thepowersgang/fyp-boat/tools/dumb_proxy/README.md

Dumb proxy that just echoes from one connection to another (multi-threaded)
