thepowersgang/fyp-boat/tools/mavlink_proxy_server/README

Hackjob program to receive, parse, and re-send mavlink messages (supporting a ground station that intermittently connects to the server)
