thepowersgang/fyp-boat/DesignNotes/ZZ-APMplannerConfig.md

Serial Connection
-----------------

For wireless dongle:
- /dev/ttyUSB0 at 57600 baud

For USB:
- /dev/ttyACM0 at 115200 baud

For 3G:
- TODO!

Joystick Config
---------------

This places all control on the lefthand sitck of a Logitech dual action

Throttle: Axis 1 (Reversed)
Roll: Axis 2
