thepowersgang/fyp-boat/DesignNotes/20170327-AlternateMotors.txt

Requirements
============

- 12V input
- Max 4W power consuption

Notes
=====

- `Kv` - RPM per Volt at no load

Extras
=====

Shaft
-----
- OPTION - [https://hobbyking.com/en_us/4mm-drive-shaft-and-prop-set.html](HobbyKing)

Propeller
---------
- 57mm diameter, 3 blade prop (2x) - [https://hobbyking.com/en_us/3-blade-boat-propellers-40x57mm-2pcs-bag.html](Link)
 - Plastic
 - Price: $2.23 per pair
- NOTE: 4.8mm (3/16") shaft hole
- Pitch is ~58mm (inferred), requires ~1000rpm motor to meet 1m/s

Options
=======

CDM - DC Brushless Motor for Fanner, 12V 6000rpm No Load, 4W Output Power
------
- "CDM" CDM-BL3626I-T1201
- [http://www.globalsources.com/si/AS/Dongguan-Country/6008849101954/pdtl/DC-Brushless-Motor/1123731124.htm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](Store link)
- Extras:
 - PWM input
 - Speed feedback

Brushless DC Motor with Encoder 12V 159RPM
----
- "DFRobot Australia" DF-FIT0441
- NOTE: Unknown power, probably 4W
- [https://littlebirdelectronics.com.au/products/brushless-dc-motor-with-encoder-12v-159rpm](Store Link) 
- Extras:
 - PWM speed control
 - Direction control
 - Feedback pulse output
- NOTE: Will likely require a shaft seal to keep the motor inside and dry.
 - Shaft extension: 
 - Shaft seal: [http://www.sealingaustralia.com.au/v-rings/](3.5mm seal)
 - Plug: ? (must be about 1cm diameter to fit the above seal)

- PROBLEM: 159 RPM is far too slow for our needs. Need about 500RPM to meet 1m/s with most small props

OpenROV motors
--------------
- [https://store.openrov.com/collections/2-8-replacement-parts/products/motor-set](Store Link)
 - [https://hobbyking.com/en_us/turnigy-aerodrive-dst-700-brushless-outrunner-motor-700kv.html](Direct motor link)
 - Possible - [https://forum.openrov.com/t/dst-700-motors-for-salt-water-mark-motors-part-3/1942/6](Waterproofing patch)
- Brushless DC motors with insulation changes
- Require silicon lubricant to prevent corrosion in salt water.
- Max power: 140W
 - NOTE: This is higher than the BlueRobotics motors (at 130W)
- No-load power: 7.2W

Submersible Pump (Bilge Pump)
--------------
- Suggested by [http://www.instructables.com/id/How-to-build-a-thruster-for-a-homemade-submersible/?ALLSTEPS](Instructables)
- Uses a 4160 l/hr pump (1.2l/sec)
 - [http://www.bcf.com.au/Product/Rule-Bilge-Pumps/124209](Store Link)
 - 3.3A max draw - ~40W
- (+) Already watertight (well, can handle being underwater)
- (-) Possibly unable to go backwards? (Not sure if the motor is capable of running in reverse)
- [http://store.waterpumpsupply.com/runo12vodcbi.html](Extra stats)

Internal Motor
-------------
- Motor [https://hobbyking.com/en_us/turnigy-xk3674-1400kv-brushless-inrunner.html](HobbyKing)
- Gearbox [https://hobbyking.com/en_us/gear-box-1-5mm-10t-64t.html](HobbyKing)

Water Feature Pump
-----------------
- [https://www.bunnings.com.au/aquapro-low-voltage-water-feature-pump_p2810056](Bunnings)
- "Thrust" - 750l/h at 1.5m head

Electic Outboard
-------------------
- [http://www.bcf.com.au/Product/Watersnake-Electric-Motor-Transom-Mount-18lb/165724](BCF)
 - AU$169
- 18lbf (8.1kgf / ~85N) peak thrust
- 12V with 15A max draw (unit has two settings, 15A and 7A)
 - [https://www.jarviswalker.com.au/catalogue/boating/watersnake-motors/transom-mount-electric-motors/watersnake-kayak-motor-bracket-combo.html](Manufacturer?)
 - 180W peak, 84W for low power mode

Decision
========

Easiest: Bilge Pump
------------------
The easiest option here is using a small bilge pump. These are designed to be submerged un seawater, and have been shown to work as thrusters. The only downside of taking one of these is that it is unknown if they can be run backwards (very quick investigations say no).
The other risk here is that these motors may not be very easy to regulate (with the only regulation option being avaliable power, no speed feedback).

The lack of reverse may not be an issue, assuming we do not need to do precise station keeping (or have to do a standing/sharp turn)

Second: OpenROV motors
---------------------
The OpenROV motors are not sealed, so they will either need to be treated to withstand constant immersion in a saline enviroment, or we hope that constant immersion won't cause issues. These have the large upside of being fully regulatable DC motors (so they can be reversed and have a controllable speed). The problem here is that our constant driving power is quite a bit below their max power rating (and is around their zero-load power drain).

Third: Just use a BlueRobotics thruster
-------------------
Since the OpenROV motors are so overpowered (compared to our power capacity), we could just got for the BlueRobotics thrusters (already used on one of the AUVs), and run them at the peak efficiency point.

Fourth: Internal motor connected via a shaft seal
--------------------------
Complex, but allows using a fully-featured and well-sized motor without caring about getting it wet. Problem may be finding a suitably sized seal for the motor shaft. (Shrink-wrap spacers could be used to pad out the shaft so it fits the seal, or a larger shaft could be attached).

Calculations
============

Thrust
------

Most recent drag calculation is _41N_ (at an unknown velocity, likely 1.3m/s)

Effective thrust is calculated by multiplying the shaft RPM by the advance of the propellor (and reducing to account for compression, rotation, and edge losses)
- Prop advance: 18mm run, ~110 degrees, ~25mm blade length (assume flat, it isn't)
 - Pitch is the distance the prop would move if the fluid were non-compressable
 - P ~= C / W * L => P = 360 / 110 * 18mm = ~58mm pitch
 - P * Area of blades ~= volume of moved water
 - `58mm * (2 * pi * 57^2 - 2 * pi * 6^2)` (6mm hub assumed)
  - `1.17e6` mm^3 per revolution (1.171 l/rev)
 - Water is moved at a speed of `RPM / 60 * Pitch`
 - Force comes from the difference between intake and exhaust velocities
 - A ballpark time (for acceleration and hence force) can be obtained by assuming a mean velocity of `(V_{in} + V_{out}) / 2`

- `V_{out} = RPM / 60 * 58mm`
- `deltaV = V_{out} - V_{in}`
- `time = 58mm / (V_{in}/2 + deltaV/2)`
- `accel = deltaV / time`
 - `accel = (V_{out} - V_{in}) / ( 58mm / (V_{in}/2 + V_{out}/2) )`
 - `accel = (V_{out} - V_{in}) * (V_{in}/2 + V_{out}/ 2) / 58mm`
 - `accel = (V_{out}^2 - V_{in}^2) / (2 * 58mm)`
- `force = 1.171kg * accel`

### DST-700 (OpenRov)
- Test data from [https://hobbyking.com/en_us/turnigy-aerodrive-dst-700-brushless-outrunner-motor-700kv.html](HobbyKing)
 - 0.82kgf (8N) thrust at 130W
 - Assume linear (bad assumption), max thrust at ~5W draw would be 0.31N

### BlueRobotics
- T200 has peak efficiency at 1570us, 0.51lbf (2.26N) thrust at 5.51W draw.
 - Required draw for overcoming above drag is 79W ea (1770us)

### FIT0441
- 159RPM, using above calc that's about 186l/min moved at max speed (assuming no slip and no loss)
 - Static thrust (`V_{in}=0`) with 58mm pitch prop is approximately 0.25N

### Bilge Pump ("Rule" 25D)
- Numbers from [http://store.waterpumpsupply.com/runo12vodcbi.html](Extra stats)
 - 6.7' head height can deliver 180GPH at 12V (680LPH)
 - 2.04m at 0.19l/s
 - 2.04m of water assuming the pipe diameter constant at 1.9cm gives a volume of 4.6 liters (~4.6 kg)
 - 4.6kgf (45N) at max power 1.9A/12V
 - Assuming linear relation of power to thrust, at ~5W we'd get 9.8N thrust per motor

### Water pump
- Obtain exhaust speed from output diameter and flow rate.
 - `v = rate / output_area`
- E.g. 750LPH pump pushing a 20mm tube
 - `v = ( 750 / 1000 / 3600 ) / (pi * 0.02^2)` (working in meters and seconds)
 - `v = 0.165... m/s`

- TODO: Head height vs avaliable force.

<!-- vim: ft=markdown
-->
