thepowersgang/fyp-boat/DesignNotes/Block Diagram 2.odp

Satellite Modem

Motor Controller

APM2.8 Board

Battery

12V → +Vin

0V → GND

DC-DC

Solar Panel

Motor + Prop

Motor + Prop

Data Logger

GPS
