thepowersgang/fyp-boat/DesignNotes/Block Diagram.pptx

Data logger

TTL UART
→UART0 (3DA-RADIO)

GPS

TTL UART
→ UART1 (GPS)

3.3V→3.3V
GND → GND

Satellite

TTL UART
→UART2 (Pads)
GND → GND

12V → 12V
0V → 0V

IO board
- APM2.6

Output 1 → PWM1
Output 2 → PWM2
Output 3 → DIR1
Output 4 → DIR2
GND → GND

+Vout → 5V
COM → GND

Regulator

12V → +Vin
0V → COM

Port

Propeller

Motor

M1A,M1B

Motor driver

Propeller

Starboard

Motor

M2A,M2B

12V → B+
0V→ B-

Battery

12V → 12V
0V → 0V

Solar panel
