thepowersgang/fyp-boat/Documents/0x-FinalPartsList.tex

\documentclass{article}
\begin{document}

\section{Major Components}
\begin{itemize}
\item{Autopilot} - ArduCopter v2.8 Board
\item{Serial proxy} - XTWduino nano V3.0 (ATMEGA328P)
\item{Batteries} (4) Henda HT12V3.3 Sealed Lead-Acid Batteries
\item{Motors} (2) BlueRobotics T100 thrusters
\end{itemize}

\section{Connections}
\begin{itemize}
\item{Power Cable} (?m) DC power cable
\item{Data Cable} (?m) signal cables
\item{APM Power Connection (housing)} (1x) Hirose DF13 6S 1.25C
\item{APM Telemtry Connection (housing)} (1x) Hirose DF13 5S 1.25C
\item{Hirose Pin Crimps} (11) Hirose DF13 Crimp Terminal Female
\item{Battery Connectors} (2x4) 4.8mm spade crimps female
\end{itemize}

\subsection{Battery Connectors}
\begin{itemize}
\item \url{http://www.altronics.com.au/p/h1991a-red-4.8mm-female-spade-crimp-pk-10/} Altronics - 10 pack (red)
\item \url{http://www.altronics.com.au/p/h1994a-blue-4.8mm-female-spade-crimp-pk-10/} Altronics - 10 pack (blue)
\end{itemize}

\end{document}
