thepowersgang/fyp-boat/Documents/BillOfMaterials.ods

Sheet: Sheet1
Bill of Materials (BOM)
 |  | INPUT |  |  |  | ALERT
Component | Unit Qty. | Unit Cost ($) | Shipping ($) | Net Cost (?) | Currency | Net Cost ($) | Store | Location | Manufacturer Product ID | Arrived (Y/N) | Stock Qty. | unit | Qty. Used | unit | Link
Solar Panel | 1 | $261.84 | $0.00 | $261.84 | AUD | $261.84 | Ebay | Online |  | N | 0 | pce | 0 | pce | http://www.ebay.com.au/itm/132017117168
Solar Charger | 1 | $31.21 | $0.00 | $31.21 | AUD | $31.21 | Ebay | Online |  | N | 0 | pce | 0 | pce | http://www.ebay.com.au/itm/172343909750
Thrusters + ECU | 2 | $144.00 | $35.00 | $323.00 | USD | $439.28 | BlueRobotics | Online |  | N | 0 | pce | 0 | pce | http://bluerobotics.com/store/thrusters/t100-thruster/
Bracket | 2 | $5.00 | $0.00 | $10.00 | USD | $13.60 | BlueRobotics | Online |  | N | 0 | pce | 0 | pce | http://bluerobotics.com/store/thrusters/t100-p-bracket-r1/
RS232→TTL Board | 1 | $6.25 | $0.00 | $6.25 | AUD | $6.25 | Ebay | Online |  | N | 0 | pce | 0 | pce | http://www.ebay.com.au/itm/262728237318
5V Suply | 1 | $4.95 | $0.00 | $4.95 | AUD | $4.95 | GPIO Australia | Online |  | N | 0 | pce | 0 | pce | https://www.buyraspberrypi.com.au/shop/12-volt-to-5-volt-3000ma-step-down-transformer/
2.25mm 4pin DF13 | 1 | $1.40 | $0.00 | $1.40 | AUD | $1.40 | RS Electronics | Online |  | N | 0 | bag | 0.1 | bag | http://au.rs-online.com/web/p/pcb-connector-housings/0143009/
2.25mm 6pin DF14 | 1 | $1.22 | $0.00 | $1.22 | AUD | $1.22 | RS Electronics | Online |  | N | 0 | bag | 0.1 | bag | http://au.rs-online.com/web/p/products/0143021/
2.25mm crimps | 1 | $7.95 | $0.00 | $7.95 | AUD | $7.95 | RS Electronics | Online |  | N | 1 | bag | 0.1 | bag | http://au.rs-online.com/web/p/pcb-connector-contacts/5038325/
2.1mm DC Jack | 1 | $2.09 | $0.00 | $2.09 | AUD | $2.09 | RS Electronics | Online |  | N | 0 | pce | 1 | pce | http://au.rs-online.com/web/p/dc-power-plugs/5051558/
Various Wire (26AWG) | 3.7 | $0.30 | $0.00 | $1.11 | AUD | $1.11 | Altronics | Perth |  | N | 0 | m | 3.7 | m | http://www.altronics.com.au/cable/hookup-non-shielded/?prdv=26AWG
Power Wire | 3.3 | $0.75 | $0.00 | $2.48 | AUD | $2.48 | Altronics | Perth |  | N | 0 | m | 3.3 | m | http://www.altronics.com.au/p/w2110-20-0.18-white-red-figure-8-cable/
 |  |  | Subtotal: |  |  | $745.93 |  |  |  |  | Actual Cost: |  | $6.73

Sheet: Sheet2
AUD | 1
USD | 1.36
