thepowersgang/fyp-boat/DesignNotes/parts-list.xlsx

item | link | original price | AUD | shipping cost | quantity | subtotal
Electronics Enclosure | https://www.jaycar.com.au/snap-fit-abs-enclosure-80-6-x-80-x-43-5mm/p/HB6008 | * | 5.95 | 7 | 1 | AUD 5.95
Devantech CMPS-11 tilt-compensated compass | https://www.robotgear.com.au/Product.aspx/Details/892-Devantech-CMPS11-Tilt-Compensated-Compass-Module | * | 43.95 | 9.9 | 1 | AUD 43.95
Seeeduino Mega | https://www.seeedstudio.com/Seeeduino-Mega-p-717.html | * | 56.8 |  | 1 | AUD 56.80
Pololu Servo MUX Board | https://core-electronics.com.au/pololu-4-channel-rc-servo-multiplexer-partial-kit.html | * | 10.35 | 3 | 1 | AUD 10.35
Breadboard | http://au.element14.com/multicomp/mcbb400/breadboard-solderless-abs/dp/2395961?mckv=s|pcrid|59148083448&gross_price=true&CATCI=pla-173777570208&CAAGID=12550800888&CMP=KNC-GOO-SHOPPING-2395961&CAGPSPN=pla&gclid=CNqCmq6iwdICFQsFKgodZkID6w&DM_PersistentCookieCreated=true&CAWELAID=120185580000282207 | * | 4.884 |  | 1 | AUD 4.88
Servo | https://www.jaycar.com.au/mini-servo-4-8v-6v/p/YM2760 | * | 19.95 |  | 1 | AUD 19.95
Rudder control arm (connects to servo) |  | * | 10 |  | 1 | AUD 10.00
Rudder(made of balsa, balsa sheet 0.8mm/100mm/915mm) | https://www.balsacentral.com/collections/balsa-sheets/products/plywood-2mm-to-10mm | * | 3.75 | 16.5 | 1 | AUD 3.75
Solar Cells | https://www.vicoffroad.com.au/12v-200w-solar-panel-kit-home-generator-caravan-camping-power-mono-charging-641.html.html | * | 178.95 | 0 | 1 | AUD 178.95
Boat deck (0.6mm / 300x915mm) | https://www.balsacentral.com/collections/balsa-sheets/products/plywood-2mm-to-10mm | * | 13.1 | 0 | 5 | AUD 65.50
Hull |  | * | 50 |  | 1 | AUD 50.00
Carbon fiber shafts with embedded electronics wiring | http://exelwebstore.com.au/exel-crosslitetm-hiilikuituputki-22-mm-740.html | * | 76.96 |  | 1 | AUD 76.96
Voltage Regulator | https://www.jaycar.com.au/products/active-components/regulators/fixed-voltage/c/212A | * | 1.85 | 0 | 1 | AUD 1.85
Battery controller and D/C regulator | http://au.element14.com/murata-power-solutions/okr-t-10-w12-c/dc-dc-converter-non-iso-pol-1/dp/1792312?mckv=s|pcrid|59148083448&gross_price=true&CATCI=aud-112905144048:pla-173777534688&CAAGID=12550800888&CMP=KNC-GOO-SHOPPING-1792312&CAGPSPN=pla&gclid=CJyi0M7bw9ICFVNwvAodVqEAsA&CAWELAID=120185580000194262 | * | 21.406 | 0 | 1 | AUD 21.41
Batteries/12V 40AH | http://www.batteriesdirect.com.au/shop/product/4424/ns40zlsmf.html?gclid=CIC02unn49ICFVgnvQodf2gEQw | * | 95 | 36.29 |  | AUD 95.00
Balancing Board | https://www.balsacentral.com/products/balsa-sheet?variant=26782433667 | * | 4.65 | 0 | 1 | AUD 4.65
4:1 belt drive reduction using GT2 timing belt | https://australianrobotics.com.au/collections/linear-motion/products/gt2-timing-belt-and-pulleys-pack | * | 18.95 |  | 1 | AUD 18.95
brushless motor/ | http://www.ebay.com.au/itm/131723659050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 | 0 | 0 | 0 | 0 | 0
Keel enclosure | this is made by using a mold. I asked what is made of. | * | 0 |  | 1 | AUD 0.00
Two way satellite modem from Rock Seven | https://www.rock7.com/shop-product-detail?productId=4 | £209+bundle price £20 | 306.099 | £29.95 | 1 | AUD 306.10
audino nano | https://core-electronics.com.au/arduino-nano-v3-2.html | * | 36 | 3 | 1 | AUD 36.00
Adafruit GPS | https://core-electronics.com.au/adafruit-ultimate-gps-breakout-66-channel-w-10-hz-updates-version-3.html | * | 67 | 3 | 1 | 67
battery charger
motor driver | http://www.robotshop.com/en/10a-5-30v-dual-channel-dc-motor-driver.html | * | 20.32 |  | 1 | 20.32
 |  | 1USD = 1.32AUD
 |  | 1£ = 1.62AUD |  |  | total | AUD 1098.32
