thepowersgang/fyp-boat/DesignNotes/PartsList-2.xls

Role | Item Name | Part Number | Unit Price | Shipping | Total price | Currency | (AUD) | Store Link | Curency | ExchangeRate
ArduPilot UC | ArduPilot APM 2.8 Flight Controller Board | APM2.8-1 | 34.99 | 13 | $47.99 | GBP | $78.70 | https://www.unmannedtechshop.co.uk/ardupilot-apm-2-8-flight-controller-board/ | AUD | 1
Battery | Century NS40ZLSMF Hi Performance | NS40ZLS | $95.00 | $36.30 | $131.30 | AUD | $131.30 | http://www.batteriesdirect.com.au/shop/product/4424/ns40zlsmf.html | GBP | 1.64
Solar Panel | 12V 200W Solar Panel Kit Home Generator Caravan Camping Power Mono Charging PWM | - | $211.90 |  | $211.90 | AUD | $211.90 | https://pethomeoutdoor.com.au/products/12v-200w-solar-panel-kit-home-generator-caravan-camping-power-mono-charging-pwm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 | USD | 1.31
DC-DC Trans | MURATA POWER SOLUTIONS OKR-T/10-W12-C DC-DC CONVERTER, NON ISO POL, 1 O/P, 50W, 590mV to 6V | OKR-T/10-W12-C | $20.94 |  | $20.94 | AUD | $20.94 | au.element14.com/murata-power-solutions/okr-t-10-w12-c/dc-dc-converter-non-iso-pol-1/dp/1792312
Sattelite Modem | RockBlock+ | - | 209 |  | $209.00 | GBP | $342.76 | https://www.rock7.com/shop-product-detail?productId=4
GPS | Adafruit Ultimate GPS Breakout - 66 channel w/10 Hz updates - Version 3 | - | $67.00 | $3.00 | $70.00 | AUD | $70.00 | https://core-electronics.com.au/adafruit-ultimate-gps-breakout-66-channel-w-10-hz-updates-version-3.html
Data Logger | SparkFun OpenLog | DEV-13712 | $14.95 | $25.31 | $40.26 | USD | $52.74 | https://www.sparkfun.com/products/13712
Motor Controller | 10A 5-25V Dual Channel DC Motor Driver | RB-Cyt-153 | $23.49 |  | $23.49 | USD | $30.77 | http://www.robotshop.com/en/10a-5-30v-dual-channel-dc-motor-driver.html#Specifications
Motor+Prop | WATERSNAKE ASP T18/24-SW TRANSOM MOTOR | 55043 | 109 | 0 | $109.00 | AUD | $109.00 | http://www.ebay.com.au/itm/131723659050
 |  |  |  |  |  |  | $1048.12
