thepowersgang/fyp-boat/DesignNotes/20171030-TODO.md

Results from the matilda bay test

- Need a magnetometer (compass)
 > Manual override?
- Battery failsafe should only apply in AUTO
 > I.e. when in manual, won't toggle between states
- Battery failsafe accout for time
- Control loop tuning
- Shoreside control via 3G (at least mapping and state control)
