thepowersgang/fyp-boat/(commit log)

2017-03-31 Design Notes - Power usage calculations
2017-03-31 Firmware - Extended SBD driver
2017-04-01 Proposal - Update with motor research
2017-04-02 Proposal - Pumps
2017-04-06 Alternate motors design
2017-04-07 Design notes - Fucking motors
2017-04-13 Motor options 2 (hopefully final), change solar panel to smaller 100W one
2017-04-20 Scripts - Basic joystick driver
2017-04-20 Joystick - Fix button values
    [joystick.py]
2017-05-12 Misc checkin
    [BillOfMaterials.ods]
2017-05-29 Eagle Schematics - Start on the wiring diagram
    [WiringDiagram.sch]
2017-06-01 Eagle - More work on wiring diagram
    [WiringDiagram.sch]
2017-07-14 EXTERNAL - Downloaded schematic/board for the APM 2.5
    [APM_v252_RELEASE.brd, APM_v252_RELEASE.sch]
2017-07-17 Writing dickery
    [WiringDiagram.sch]
2017-08-25 Wiring diragram, meh
    [WiringDiagram.sch]
2017-08-25 Design notes - tweaks, and battery level circuit
2017-09-18 Add a basic working configuration (can be controlled with a patched APMplanner2)
    [WorkingConfig.param]
2017-09-21 Firmware config, readme
    [WorkingConfig.param]
2017-09-25 Working Config - Reduce throttle
    [WorkingConfig.param]
2017-09-29 Firmware - Tested 3g telem (with USB-RS232 cable), partially working
2017-10-06 Updated configuration
    [WorkingConfig.param]
2017-10-10 Config - Fix battery scaling
    [WorkingConfig.param]
