thepowersgang/fyp-boat/(notices)

Notices in the files:
parts and their libraries:
SparkFun: Released under the Creative Commons Attribution Share-Alike 3.0 License
SparkFun: http://creativecommons.org/licenses/by-sa/3.0
